HebiRobotics/hebi-matlab-examples/kits/lily/images/lily_axis.pptx

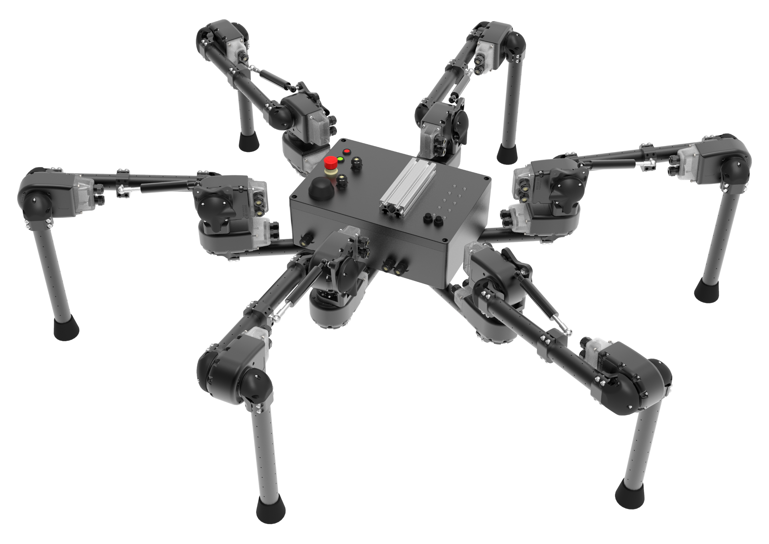
[picture p5: figure]

+z

+y

+x
