HebiRobotics/hebi-matlab-examples/kits/daisy/images/daisy_coordinates.png

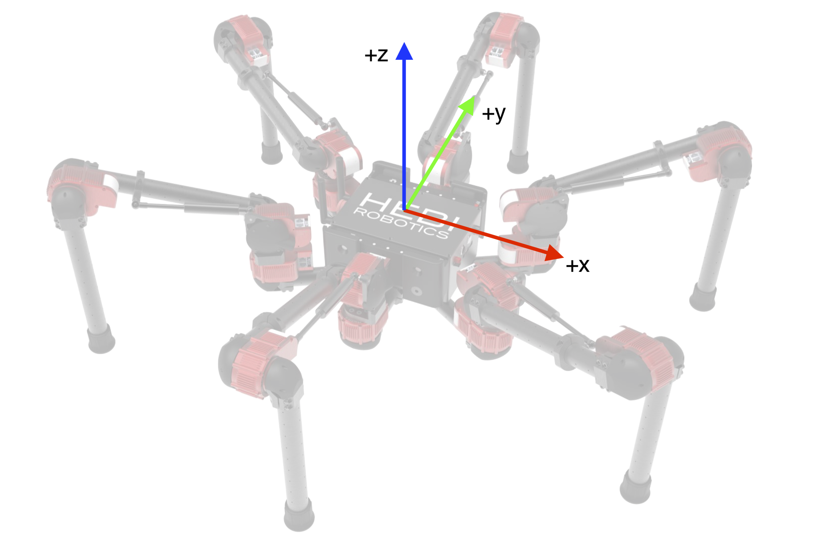
kits/daisy/images/daisy_coordinates.png
