HebiRobotics/hebi-matlab-examples/kits/lily/images/lily_render.png

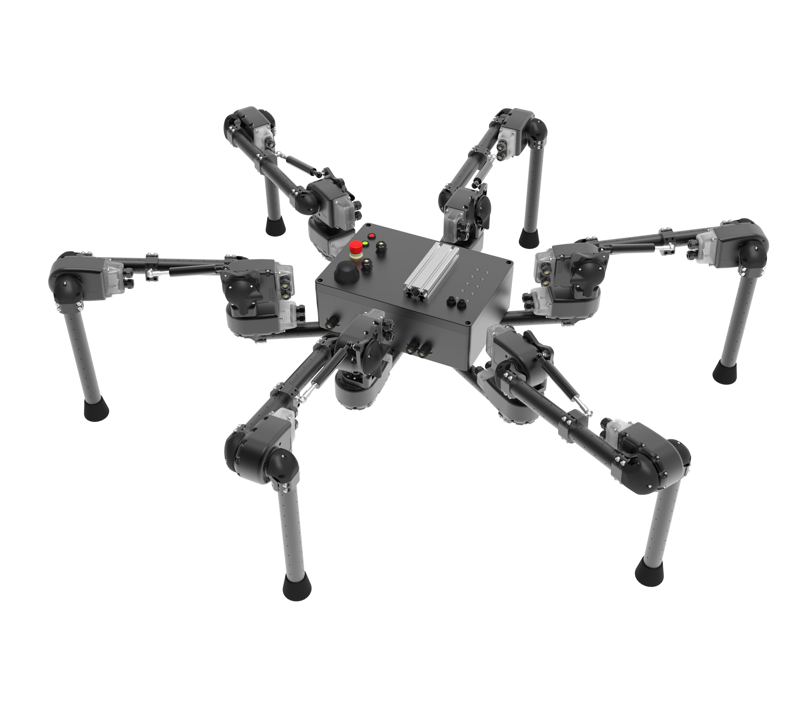
kits/lily/images/lily_render.png
