HebiRobotics/hebi-matlab-examples/kits/arms/hrdf/T25/hrdf/Can be converted to Mesh/Non-Simplified Size 55 Link/Size55Link.SLDASM

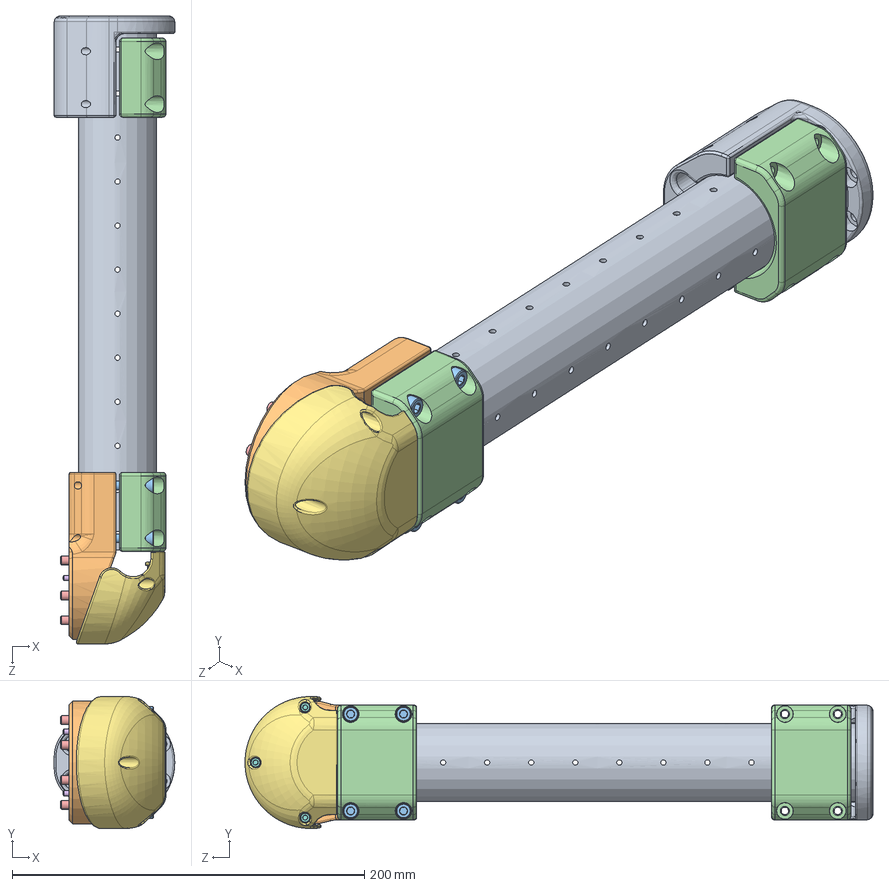
[picture p9: CAD file, 2024-07-16]
kits/arms/hrdf/T25/hrdf/Can be converted to Mesh/Non-Simplified Size 55 Link/Size55Link.SLDASM
68.5 x 75.0 x 356.5 mm
PM-3230-300
PM-3242-01
PP-2410-25 x 4
PM-3232-01 x 2
PP-2410-10 x 6
PP-2452-08 x 3
PM-3265-01
PP-2346-14 x 3
PM-3270-01
