HebiRobotics/hebi-matlab-examples/kits/arms/hrdf/T25/hrdf/Can be converted to Mesh/A-2638-01/A-2638-01.STEP

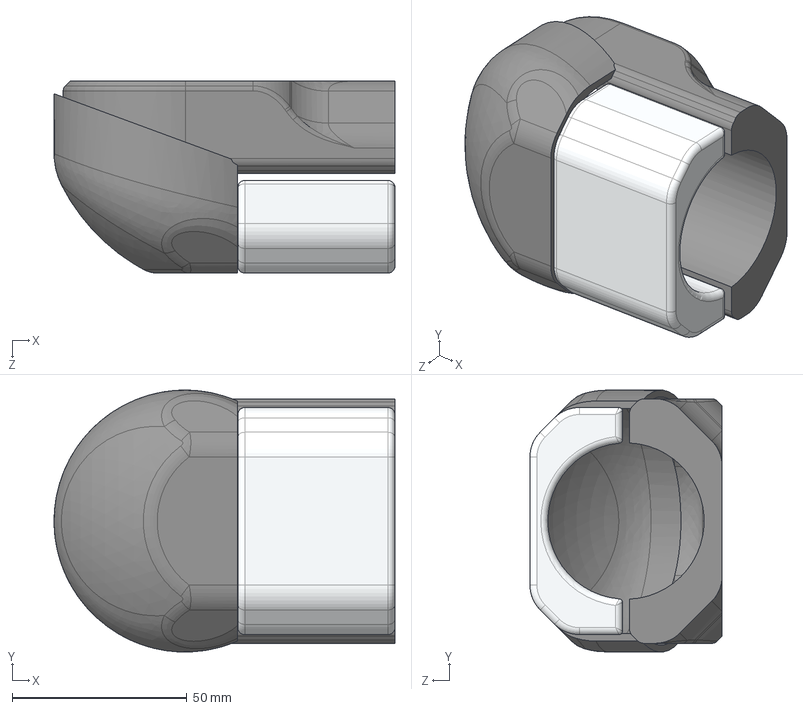
[picture p10: CAD file, 2024-07-15]
kits/arms/hrdf/T25/hrdf/Can be converted to Mesh/A-2638-01/A-2638-01.STEP
97.6 x 75.0 x 55.0 mm
PM-3231-01
PM-3232-01
PM-3252-01
