HebiRobotics/hebi-matlab-examples/kits/arms/hrdf/T25/hrdf/Can be converted to Mesh/A-2639-01/A-2639-01.STEP

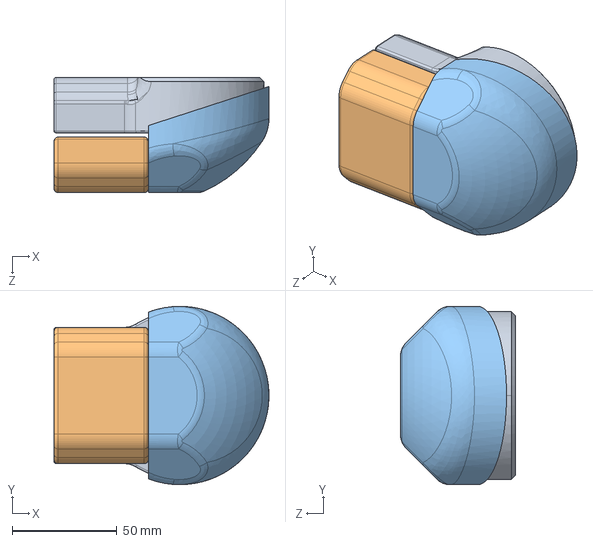
[picture p11: CAD file, 2024-07-15]
kits/arms/hrdf/T25/hrdf/Can be converted to Mesh/A-2639-01/A-2639-01.STEP
102.5 x 85.0 x 55.0 mm
