HebiRobotics/hebi-matlab-examples/kits/arms/hrdf/T25/hrdf/Can be converted to Mesh/A-2640-01/A-2640-01.STEP

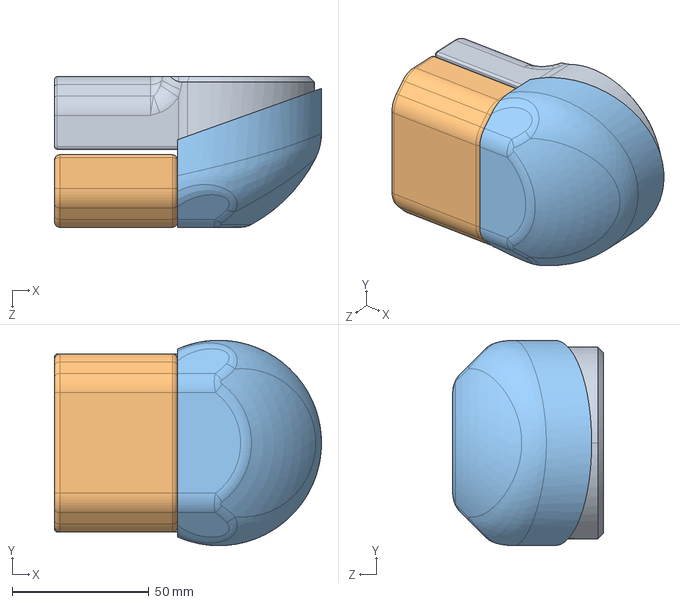
[picture p12: CAD file, 2024-07-15]
kits/arms/hrdf/T25/hrdf/Can be converted to Mesh/A-2640-01/A-2640-01.STEP
97.5 x 75.0 x 55.0 mm
