HebiRobotics/hebi-matlab-examples/kits/arms/hrdf/T25/hrdf/Can be converted to Mesh/A-2641-01/A-2641-01.STEP

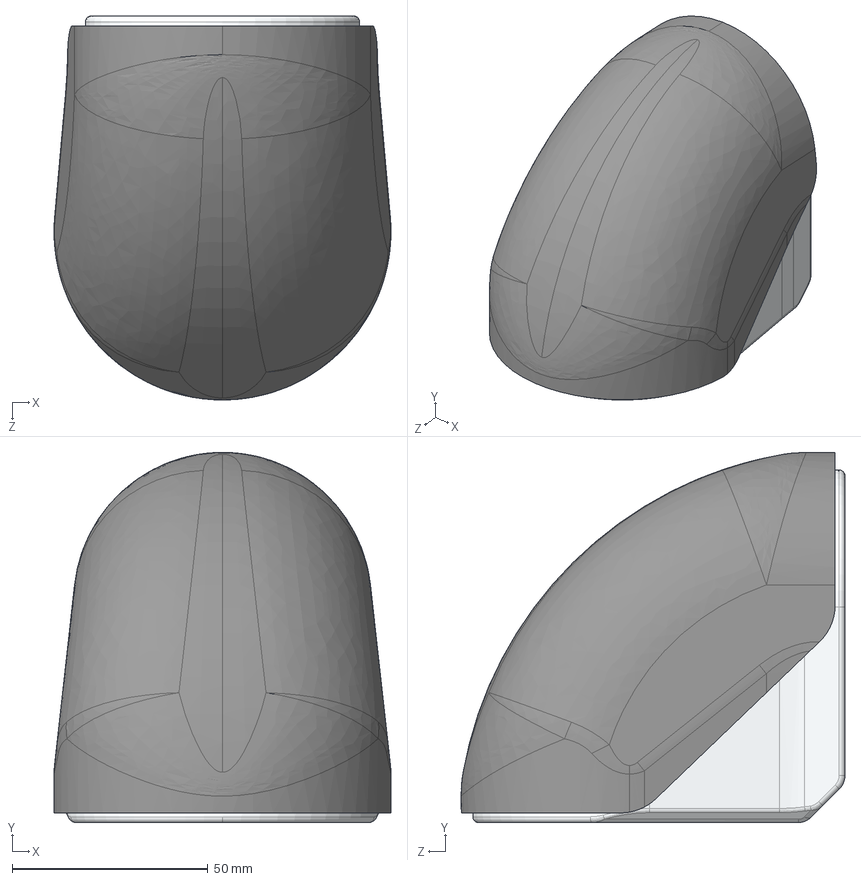
[picture p13: CAD file, 2024-07-15]
kits/arms/hrdf/T25/hrdf/Can be converted to Mesh/A-2641-01/A-2641-01.STEP
86.0 x 94.5 x 98.0 mm
PM-3245-01
PM-3266-01
