HebiRobotics/hebi-matlab-examples/kits/arms/hrdf/T25/hrdf/meshes/A-2641-01.obj

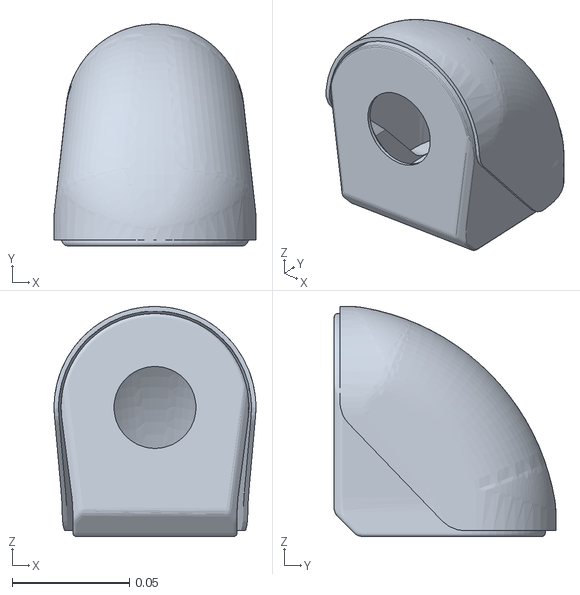
[picture p16: CAD file, 2024-07-15]
kits/arms/hrdf/T25/hrdf/meshes/A-2641-01.obj
0.086 x 0.0945 x 0.098
