HebiRobotics/hebi-matlab-examples/kits/arms/hrdf/T25/hrdf/Can be converted to Mesh/Non-Simplified Size 55 Link/Size_55_To_55_Inline_Link_Twist_0.SLDPRT

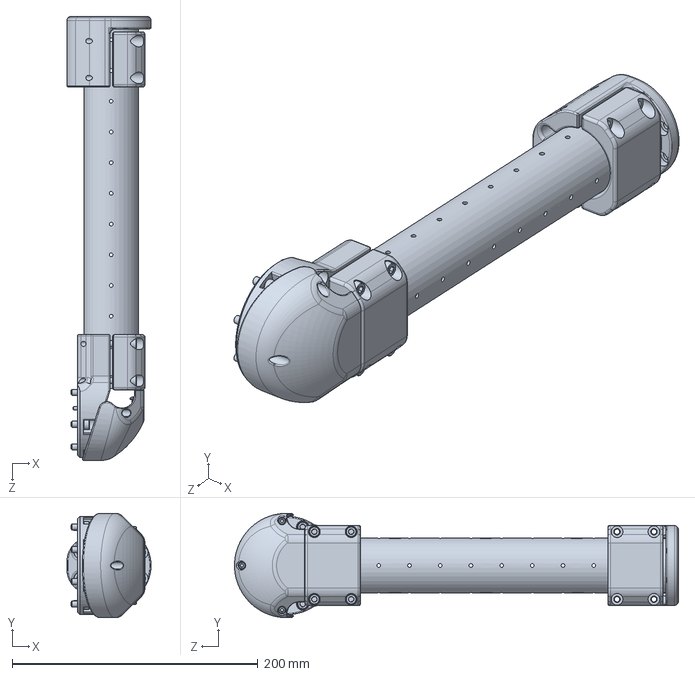
[picture p17: CAD file, 2024-07-16]
kits/arms/hrdf/T25/hrdf/Can be converted to Mesh/Non-Simplified Size 55 Link/Size_55_To_55_Inline_Link_Twist_0.SLDPRT
68.5 x 85.0 x 361.5 mm
