HebiRobotics/hebi-matlab-examples/(list of files, cad)

Other CAD files:
kits/arms/hrdf/T25/hrdf/Can be converted to Mesh/A-2642-01_Right_Inside/A-2642-01_Right_Inside.SLDPRT
kits/arms/hrdf/T25/hrdf/Can be converted to Mesh/A-2642-01_Right_Outside/A-2642-01_Right_Outside.SLDPRT
kits/arms/hrdf/T25/hrdf/Can be converted to Mesh/A-2642-01_Left_Inside/A-2642-01_Left_Inside.SLDPRT
kits/arms/hrdf/T25/hrdf/Can be converted to Mesh/A-2642-01_Left_Outside/A-2642-01_Left_Outside.SLDPRT
kits/arms/hrdf/T25/hrdf/Can be converted to Mesh/A-2642-01_Right_Inside/A-2642-01.STEP
kits/arms/hrdf/T25/hrdf/Can be converted to Mesh/A-2642-01_Right_Outside/A-2642-01.STEP
kits/arms/hrdf/T25/hrdf/Can be converted to Mesh/Non-Simplified Size 55 Link/Size_55_To_35_Inline_Link_Twist_0.SLDPRT
kits/arms/hrdf/T25/hrdf/Can be converted to Mesh/A-2638-01/A-2638-01.SLDPRT
kits/arms/hrdf/T25/hrdf/Can be converted to Mesh/A-2639-01/A-2639-01.SLDPRT
kits/arms/hrdf/T25/hrdf/Can be converted to Mesh/A-2640-01/A-2640-01.SLDPRT
kits/arms/hrdf/T25/hrdf/Can be converted to Mesh/A-2641-01/A-2641-01.SLDPRT
