HebiRobotics/hebi-matlab-examples/(threads)

Thread 22 (2018-06-19):

README for Igor

iamtesch, 2018-06-19:
It would be really helpful to have a "README" in the `kits/Igor` folder (and hexapod) explaining what the various startup scripts are there for, and which one to run/look at first when starting to use the kit.

iamtesch, 2018-06-19:
I see this is already done in the arm and Edward repos -- this would be great eventually, but even a 1-2 line README would help for Igor.

iamtesch, 2018-06-20:
Closing -- fixed with #23.

Closed 2018-06-20.

Thread 31 (2018-07-16):

Fix startup.m

daverolli, 2018-07-16:
Move to individual product, make sure `genpath` uses the path to the startup.m file rather than where the Matlab IDE is currently sitting.

ennerf, 2018-07-18:
Fixed in [1d722b5](https://github.com/HebiRobotics/hebi-matlab-examples/commit/1d722b5d6cb041456471a4abe5d9c49a34ba81e0)

Closed 2018-07-18.

Thread 59 (2018-07-24):

Overhaul arm kit examples

daverolli, 2018-07-24:
Suggested new examples (general to all kits):
* Forward Kinematics (show going thru preset joint waypoints)
* Forward Kinematics (controlling individual joints from sliders in Mobile I/O App)
* Inverse Kinematics (show going thru preset end-effector waypoints)
* Inverse Kinematics (controlling end-effector pose from sliders in Mobile I/O App)
* Gravity Compensation (with admittance control to hold steady)
* Impedance control (virtual wall or spring)

Suggested new examples (6-DoF w/ Gripper only):
* Teach Repeat (using Mobile I/O for input?)

Anything else?

Thread 63 (2018-07-30):

Add gas spring compensation to 6 dof basic example?

iamtesch, 2018-07-30:
In the robot 6 dof example in the "basic example" folder, it assumes no gas spring:

https://github.com/HebiRobotics/hebi-matlab-examples/blob/master/basic/x-series_actuator/ex7b_robot_6_dof_arm.m

This doesn't match our default 6DOF kit, and can lead to odd behavior in the case that this is run on a system with such a spring (b/c we are actively controlling efforts).

Should we make this a note somewhere in the file?  Or add gas spring compensation by default?

daverolli, 2018-07-30:
For the purposes of basic examples I prefer not getting into effort offsets, so adding a comment that the gas spring is off would be good.

I think the default we shoot for is that kits come with a gas spring, but I'm not sure its better have it installed by default.  I think its import to still build in support for it, but the need for a spring out of the box decreased a lot now that we have the X8-16.

Thread 102 (2019-11-18):

about motor torque controller

76328, 2019-11-18:
1.Is there any api for motor torque control?
2.Can I use the motor current and PWM to control motor torque for SEA output torque control algrothim design?
3.Dose the SEA support motor torque control like FOC?

daverolli, 2019-11-18:
> 1.Is there any api for motor torque control?
Yes.  The `effort` commands control the torque of the actuator.  This torque is measured and controlled directly on the output of the actuator using the sensed deflection of an internal spring.

> 2.Can I use the motor current and PWM to control motor torque for SEA output torque control algrothim design?
You can access the motor current in the actuator feedback, as well as command the PWM directly if desired.  So you can try closing the loop yourself for research.  However, actuators have high gear ratios, so it is unlikely that controlling current/torque of the motor directly would result in good control of output torque.

> 3.Dose the SEA support motor torque control like FOC?
The actuators do not currently support field-oriented control, or current-based control methods directly on the electric motor.  Torque control is provided by sensing directly on the output.

76328, 2019-11-18:
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

Wow,You means you use motor voltage (PWM) and a single PID loop to control the (output defelection)effort of SEA and achieve such high accuracy,it’s amazing! So Can I further ask an question,the PWM strategy is just like SVPWM technology?And there is no current based controller，you just control the output PWM which control the winding voltage，so the motor driver just like six step driver or sin wave driver not the FOC？

daverolli, 2019-11-18:
Correct, we have had good results by controlling the PWM to the motor (the winding voltage) and we do not use FOC.

Hope that helps.  If you'd like discuss more we'd be happy to continue the discussion via email at support@hebirobotics.com.

Closed 2019-11-18.

Thread 103 (2019-12-05):

How to use your winding current to calculate motor torque

76328, 2019-12-05:
I know the torque of your motor has some relationship of three phase winding currents
but the API only feedback one phase winding currents，so which phase dose it represent，and how to use it to calculate motor torque，and i want to use motor torque to do some control strategies

ennerf, 2019-12-05:
This touches internal firmware details, so we prefer to not discuss it in public issues. However, please feel free to reach out to us directly at support@hebirobotics.com

Closed 2019-12-05.

Thread 137 (2023-04-17):

How is feedback volume 'deflection' calculated?

Tom0514, 2023-04-17:
Hello, everyone!

      I am doing a single joint test, the joint model is `X5-9`. But I ran into a doubt, `deflection` is not equal to the value after subtracting the equivalent motor position from the joint position. In theory, shouldn't they be the same?

Best regards,
Xu.

ennerf, 2023-04-17:
Deflection is calculated from two encoders that are located before and after the spring attached to the output, i.e., they are after the gear train. The motor position is the position of the motor itself, i.e., it is before the gear train.

`motor -> [motor_position] -> gear train -> [deflection as offset from position] -> spring -> [position]`

ennerf, 2023-04-17:
The torque can be calculated using [Hooke's law](https://www.jamesspring.com/news/spring-constant/), i.e., `effort = -stiffness * deflection`. Note that the stiffness portion is negative, which may explain your sign error.

That being said, the springs in the X- and R-series actuators have some hysteresis effects and newer models use non-linear springs, so the stiffness depends on multiple factors and is not straight forward to compute. Each spring gets calibrated independently before shipping.

You may want to take a look at the `Encoders` section in Scope's log-viewer for more details. In the log file below the `J2_shoulder`  (red) joint shows a non-linear spring while `J5_wrist2` (green) uses a more linear spring.

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

Tom0514, 2023-04-17:
Hello, thank you for your reply!

> Edit: I somehow missed your code comment. It looks reasonable to me, but I'll ask someone else to double-check.

This code is just to verify `deflection = theta_link - theta_motor/N`, where `theta_motor/N` perform zero correction.

> The torque can be calculated using [Hooke's law](https://www.jamesspring.com/news/spring-constant/), i.e., `effort = -stiffness * deflection`. Note that the stiffness portion is negative, which may explain the sign error.

I can get the corresponding torque value through Hooke's theorem, but it has positive and negative numbers throughout the constant positive speed operation (sorry, the expression in the previous reply is too absolute, and it has positive and negative numbers in the figure). From the point of view of the formula, it should not be positive or negative.

> You may want to take a look at the `Encoders` section in Scope's log-viewer for more details. In the log file below the `J2_shoulder` (red) joint shows a non-linear spring while `J5_wrist2` (green) uses a more linear spring.

I drew it and it's a linear spring.
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

ennerf, 2023-04-17:
> This code is just to verify deflection = theta_link - theta_motor/N, where theta_motor/N perform zero correction.

That is not the case. The deflection comes from two dedicated absolute magnetic encoders and is independent of the motor and gear train. The motor-position is based on hall sensors and is not used in the effort computation at all. Between non-linearities in the encoders, gear backlash etc., I would expect the results to deviate a bit from each other.

> I can get the corresponding torque value through Hooke's theorem, but it has positive and negative numbers throughout the constant positive speed operation (sorry, the expression in the previous reply is too absolute, and it has positive and negative numbers in the figure). From the point of view of the formula, it should not be positive or negative.

Could you send us a log file to support@hebirobotics.com? A subject line "hebi-matlab-examples#137" without any text would be enough.

Tom0514, 2023-04-17:
> That is not the case. The deflection comes from two dedicated absolute magnetic encoders and is independent of the motor and gear train. The motor-position is based on hall sensors and is not used in the effort computation at all. Between non-linearities in the encoders, gear backlash etc., some deviation between the two values is to be expected.

Thank you for answering my doubts. The calculation given by the dynamic model of the joint is too ideal.

> Could you send us a log file to [support@hebirobotics.com](mailto:support@hebirobotics.com)? A subject line "hebi-matlab-examples#137" without any text would be enough.

OK, I'll send it right now.  Thank you for your answer, much appreciated!

ennerf, 2023-04-18:
The torque readings aren't great, but not out of whack for a 5 year old actuator. However, the commands are a bit weird.

You are using `DIRECT_PWM`, but something is making the command oscillate. Are you using some custom controller on top or maybe have safety limits set?

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

Tom0514, 2023-04-19:
Thank you so much! ennerf.

> You are using `DIRECT_PWM`, but something is making the command oscillate. Are you using some custom controller on top or maybe have safety limits set?

There are no other controllers on the top layer, I just control the PID to achieve constant speed movement. The safety limit parameters are set as follows:

``` matlab
safetyParams = group.getSafetyParams();
safetyParams.positionLimitStrategy = 3;        % damped spring
safetyParams.positionMinLimit = -3*pi;
safetyParams.positionMaxLimit = +3*pi;
```

Tom0514, 2023-04-19:
> What PID controller are you referring to? You are using DIRECT_PWM, which bypasses all built-in PID controllers.

Basically follow this example to write: [`ex1_custom_pid_1_controller.m`](https://github.com/HebiRobotics/hebi-matlab-examples/blob/master/advanced/ex1_custom_pid_1_controller.m)  The parameters used are `P` and `D`.

> Please try switching to Strategy 3 or 4 (see [documentation](http://docs.hebi.us/core_concepts.html#control-strategies)) and commanding velocity.

I saw in [`Choosing a Control Strategy`](https://docs.hebi.us/core_concepts.html#gain-tuning) that the `Direct PWM` strategy is suitable for system identification, so I used it. I also tried `strategy 4` and set the parameter of effort PID to 0, but the effect was worse than `strategy 1`.
I didn't tune the parameters of the position and velocity PID in `strategy 4`, because I found that even when the position and effort were set to zero, the velocity and effort still fluctuated, and I don't know if it can achieve a constant and precise speed tracking. So I use `strategy 1` to track the position of the linear transformation, so as to realize the speed tracking indirectly.

Tom0514, 2023-04-19:
> Did you zero the commands or the gains? The position/torque controller should be disabled, e.g.,

Sorry, I didn't express myself clearly.  When the joint is not running, the speed and torque still fluctuate after setting the zero position in `Scope`. When I use `strategy 4`, I only send velocity commands:

```matlab
cmd = CommandStruct();
cmd = CommandStruct();
```

Closed 2023-04-21.

Thread 139 (2023-05-10):

Can a current controller be implemented with a direct PWM strategy?

Tom0514, 2023-05-10:
Hello, ennerf !

I'm testing the `MPC` algorithm in a joint, and my control input signal is the motor winding current, i.e. `windingCurrent`. When testing the joint, I scaled the value to the `[-1,1]` interval and sent it to the motor with a `direct PWM` strategy, but the actual effect was far from the simulation result.

So, I want to track the current signal by cascading a bottom PID current controller. But when writing the current controller on the `direct PWM` strategy and applying it to the joint, the LED of the joint turns red and then makes a screeching sound. Is it possible to implement a current controller under `direct PWM` strategy? Thanks!

Best regards,
Xu.

ennerf, 2023-05-10:
It is generally possible to run a current loop on PWM (this is how FOC works in a nutshell), but it is generally timing critical and should be done in firmware. The actual equation that scales voltage to current in a motor should include the motor velocity and the winding resistance.

You are going to run into timing issues when doing it over the network, but you can maximize the feedback rate and hope for the best. As a first debugging step I'd recommend looking at logs and checking what your PWM commands look like. The red LED and sound probably indicate that your controller is unstable and oscillating.

Tom0514, 2023-05-11:
Thank you for your reply!

> You are going to run into timing issues when doing it over the network, but you can maximize the feedback rate and hope for the best.

Doesn't changing the feedback frequency affect the sampling time of `MPC`?  My sampling time is `0.01s`, so I set the feedback frequency to `100Hz`.

> The red LED and sound probably indicate that your controller is unstable and oscillating.

In the early stage of `MPC`, the output current signal has a large oscillation. I think this may be the reason. I will try to add constraints to the control input rate.

For the joint `X5-9`, when setting the state variable of `MPC` and the upper and lower bounds of the control input, the parameters I set are:

```matlab
% The state variables correspond to motor position, motor speed, link position and link speed
lbx = -1*[pi, 14/9.55, pi, 14/9.55];
ubx = +1*[pi, 14/9.55, pi, 14/9.55];
% control input: Motor winding current
lbu = -1.6;
ubu = +1.6;
```

The current is set according to the peak current in the parameter table (`1.6A @ 36V`), the speed of the motor and link is obtained from the maximum speed (`14 RPM`), and the constraints of the position of the motor and connecting rod are self-selected (`+/- 4 rotations (8 x 360-degree total range)`). Is this reasonable? Thanks!

Tom0514, 2023-05-12:
> For the joint X5-9, when setting the upper and lower bounds of the state variable and the control input of MPC, the parameters I set are:

This can give `+1/-1` commands under the `direct PWM` strategy to observe the joint output, so as to obtain the relevant upper and lower limit values.

Tom0514, 2023-05-18:
Hello, ennerf!

I have designed a `PI` current controller with a feedback frequency of `1000Hz`, and when I am tracking a fixed value of 0.1A/0.2A, it is tracking ok. But today when I was trying to trace a sequence of control input signals from the `MPC` solution, it had a problem.

Then when I try to track a higher fixed value of current under this `PI` parameter again, the feedback results are almost the same, and there is no tendency to track the target at all.

Here is my feedback plot for tracking a fixed value of current using a `PI` controller (`P-0.2`, `I-50`):
- [0.1A](https://github.com/Tom0514/issue/blob/main/0.1A.png)
- [0.2A](https://github.com/Tom0514/issue/blob/main/0.2A.png)
- [0.3A](https://github.com/Tom0514/issue/blob/main/0.3A.png)
- [0.4A](https://github.com/Tom0514/issue/blob/main/0.4A.png)
- [0.5A](https://github.com/Tom0514/issue/blob/main/0.5A.png)

The control input signals of the MPC and the corresponding simulation results (state trajectory and reference trajectory) are as follows:
- [the mpc control inputs](https://github.com/Tom0514/issue/blob/main/the%20control%20input.png)
- [state&reference trajectory](https://github.com/Tom0514/issue/blob/main/state%26reference%20trajectory.png)

Track the control input signal under the `PI` parameter:
- [track control input](https://github.com/Tom0514/issue/blob/main/mpc.png)

Is this a problem with the `PI` parameter? Why this happens, I have a hard time understanding. Here is my [code](https://github.com/Tom0514/issue/blob/main/hebi_current.m).

Hope you take a look! Thank you so much!

Best regards,
Xu.

ennerf, 2023-05-19:
I tried running your code, and I think you are running into at least two issues:

1. You may be commanding something that is physically impossible. On an unloaded X8-3 going full tilt I get a maximum motorCurrent of 0.15 amps. I'd recommend doing a sanity check where you command max pwm and check what the output is for your system.

2. You are not capping the i term, so the controller is running into [integral windup](https://en.wikipedia.org/wiki/Integral_windup) and can't recover.

Tom0514, 2023-05-19:
Thank you for your reply!  I'm going to double-check the two points you raised.  Thanks again!!!

Tom0514, 2023-05-19:
> You may be commanding something that is physically impossible. On an unloaded X8-3 going full tilt I get a maximum motorCurrent of 0.15 amps.

Sorry, the output of my actual `MPC` is `windingCurrent`, I looked at the uploaded code and wrote `motorCurrent`. At that time, in order to verify whether it was a problem with tracking signals, I tested `motorCurrent`, but I looked at the log files, and it seemed that the tracking could not be achieved.

I'll check the problem again, I'm really sorry.

Closed 2024-01-12.

Thread 141 (2024-01-12):

What is the relationship between motor current or winding current and PWM?

Tom0514, 2024-01-12:
Hello, author！

Is there a corresponding relationship between the motor current or winding current of the HEBI X5 series joints and PWM? Can I fit the mapping relationship between them through a neural network to achieve a current controller?

Looking forward to your reply, thank you very much!
