HebiRobotics/hebi-matlab-examples/(commit log)

2017-07-26 overhauled basic kinematics example
2017-08-22 * updated examples to use 1.0rc2 (torque => effort) * added non-blocking trajectory example
2017-08-28 added start for arm-kit code. Started with 5 dof I had on hand.
2017-08-29 changed output to point forward, added switch for disabling effort control
2017-08-29 sample video and control stratgies
2017-09-21 added example for shared memory communication and custom pwm controller
2017-10-09 Added hexapod code
    Added latest hexapod code from SVN. This has been updated to use the
    latest API, but hasn’t yet been tested on a real robot.
2017-10-11 Demo updates
    Simplified some of the gravcomp spring example and target chase
    example. setupArm now does a 5DOF arm that matches the configuration
    for the Nihon feeding arm. Added ignores for .hebilog.
2017-10-12 First draft of feeding demo
    Code for teach-repeat feeding, based on ex_teach_repeat.m. Added some helper tools for rotations, kinematics, visualization, etc.
2017-10-12 Changed kinematics to 'left'.
    Changed to match Nihon Binary's hardware parts.
2017-10-16 Added ability to nudge waypoints after training.
    Added IK-based waypoint adjustment after training using the arrow keys. Added a set of the base frame of the arm so that the keyboard input can be oriented correctly.
2017-10-23 added joystick sample to readme
2017-11-14 Added default gains for example 3DOF arm.
2017-11-14 Changed hackathon folder name
    Change hackathon folder name, and updated with another example of an arm that used a bottle opener to open drinks.
2018-02-12 Beverage Arm Demo
    Updated hebi API to latest version. Added code for 5DoF Arm w/ Gripper
    (Beverage Demo for PRN Event).
2018-03-02 Revert "Beverage Arm Demo"
    This reverts commit 9ec50266704f6e489db257b45fe279011663f28b.
2018-03-09 fixed arm kit startup and removed utility functions that have moved to HebiUtils API
2018-03-09 * added all standard arm kits to setupArm (breaks current demos) * updated readme
2018-03-09 changed feeding arm and youtube demos to use shared include folder
2018-03-09 added 6 dof IK for 6dof arm joystick chase
2018-04-23 fix gains for no camera Igor config
2018-05-14 Added IO board youtube demo code
2018-06-29 Added mobile device demo
    Added control from mobile phone, basically the Rosie demo, but without the mobile base. Added gain-setting for the 6-DoF arm, loading from an XML file.
2018-07-17 Reorganized utilites
    Removed unused utilities. Moved shared memory helpers to utils/. Moved frameDisplay to kinematics/. Got rid of unknown/.
2018-07-18 Basic examples update (#30)
    * Updated API version
    Updated to latest API, pre-release version of 1.4
    * Removed old files. Kept startup.m
    * Removed old resources folder
    * Added README
    * Added Lookup examples.
    * Added feedback examples
    Added 2 examples for getting feedback in a loop, with and without logging. Also fixed the descriptions on some of the lookup examples.
    * Added command examples
    Added command examples. Removed note about maybe doing single modules from the readme. Added some printouts to the feedback examples to encourage people to mess with the module while gathering feedback.
    * Added closed-loop command example.
    Added exmple using gyro to sen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
2018-07-20 Updated frameDisplay() to allow fixed xyz limits
2018-07-23 Dave Rosie kit updates (#49)
    * Added Rosie code.
    * Fixed coordinate convention and startup crash for omnidrive
    * Added arm gains
    * Updated with setting gains for the arm.
    * Updated demo runner for omni-base
    * Added gripper force scaling based on setup parameters.
    * Resolved conflicts with master
    * Commented out 'clear' commands in SpinCalc
    * Fixed minor comments typos
    * Removed local `hebi` API - Changed `include.m` to use the main examples API. Removed all the local versions of the API and tools.
    * Added gains and HRDF files
    * Updated orientation code to use fixed axis limits.
    * Added placeholder for unified Rosie Demo
    * Updated to API 1.4.2
    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
2018-07-30 Basic mobile examples (#60)
    * Changed 'hexapod' to 'daisy'
    * Updated startup script
    * Re-orged gains in arm kit.
    * Added logging to Mobile I/O example
    * 3 tabs to 2 tabs
    * Initial commit of scanning arm.
    * removed logging from earlier examples, added example with IO and mobile fbk
    * Changed to remove `vecnorm`
    Do vector norm manually so that demo works with older versions of Matlab
    * Added axis labels.
2018-07-30 change plane of box in IK example (#65)
    Again, for 6DOF arm, the area around the ray [0.2, 0.2, z > 0] seems to be a bad area of the workspace.
2018-07-30 Change path in IK example (#62)
    On the basic IK example, it traces a straight line from [0.5, -0.2, 0] to [-0.5, -0.2, 0]. This works OK on the 3 dof arm, but points that are passed through in the vicinity of [0.2, -0.2, 0] tend to be a little collision prone with a 6 DOF arm, given the wrist and the gas spring. I found a trajectory of [0.5, -0.2, 0] to [0.5, 0.2, 0] to work better here, and I think it would work well on the 3 DOF arm as well. It also seems to center better in the default workspace (so an elbow up configuration with base angle "0" is in the middle).
    Thoughts?
2018-07-31 Add an advanced IK example demonstrating IK error (#69)
    * Add an advanced IK example demonstrating IK error
    - demonstrates how to compute cartesian error from target position to
    IK solution
    - demonstrates behavior when target point is outside of the workspace
    or the arm begins at a singularity.
    * Added HRDF and fixed reference in code.
2018-08-14 Fixed arm gains file capitalization issues.
2018-11-02 Arm kit updates (#73)
    A whole mess of changes to the arm kit. Main updates are now using gains XML files for all arms and using HRDF for all the kinematics. Also did a rework of the examples based on new tools like the Mobile I/O app and trying to make things easier to extend for specific applications, like the `ex_teach_repeat` examples.
    * Added scanning demo
    * Added some bells and whistles
    Use the mobile app to start / jog / pause.
    * Update to use Mobile Device API
    Took out the co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
2018-11-30 Fixed bug with Shoulder bracket configuration (#76)
    Chaged 'RightOutside' to 'RightInside'.
2019-04-05 Willig updates to Igor 2 MATLAB example (#80)
    * Mobile IO Igor from Joystick
    Updating Igor MATLAB example code to work from Mobile IO instead of joystick.
    * Igor Mobile IO bugs
    Made bug fixes to igor demo with mobile IO
    * Update igorStart.sh
    fixed .sh file called directory.
    * Update igor2DemoIntegrated.m
    changed some LED sequencing. and removed a break that caused demo to startup while paused and disconnected controller.
    * Update igor2DemoIntegrated.m
    Included try/catch for if app closes while demo is running.
    * Update igor2DemoIntegrated.m
    removed excessive try catch in control loop. My bad!
    * Update igor2DemoIntegrated.m
    updated igor Mobile IO code wi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
2019-04-17 Update igor2DemoIntegrated.m (#85)
    Re-tuned balance control for upcoming improvements to the pose filter. Added mobile control state-setting. Added velocity control integral gains to slider A5.
    * Added note about firmware version to the README
    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
2019-06-12 Create 5-Dof arm with gripper (#98)
    * Create 5-Dof arm with gripper
    * Added 5-DoF Arm w/ Gripper. Changed gas spring default to false.
2019-12-02 R-Series Hexapod in MATLAB
    Starting to get things working for R-Series Hexapod. Scaled gains up to 1.0 from 0.5. Adjusted some chassis masses. Waiting on gas springs to do more development.
2019-12-03 More work
    Fixed some kinematics issues in terms hrdf formatting and bugs that Florian fixed in 1.6.3-SNAPSHOT. Made larger stance radius and step period. Trippled Position and Velocity P gains. still some leaning issues, but she can walk a little!
2019-12-11 Added Springs to R-Series Hexapod - Lily
    Calling R-Series Hexapod - Lily (Water Lily). Added effort compensation for springs back as I installed the 30lbs gas springs.
2019-12-17 Update readme.adoc
    updated readme doc for arm examples to include r-Series.
2019-12-19 Cleaned up Daisy
    Removed Lily draft code. Made changes for Daisy to use new MATLAB API (updating HRDFs and some frames stuff). Tested both Daisy and Lily on physical robots. This MATLAB code is pretty basic to get people started.
2020-01-20 MATLAB Arm Examples Update (#106)
    * MATLAB Examples update Arm Kits
    Using Kit Part Numbers for HRDF and gain files. Updated all examples to no longer use `series` and the `names` are all by Kit Part Numbers. Updated the ReadMe file to match changes.
    * Added comments
    Added comments for gripper spool gains files and callouts on setupArm.m
2020-01-20 Add R-Series SCARA to MATLAB Arm Examples (#107)
    * Added R-Series SCARA Arm
    Added R-Series SCARA Arm HRDF, gains and to setupARM. Fixed X-Series SCARA HRDF kinematics.
    * Update A-2302-01.xml
    fixed comment
2020-03-20 Arm interface (#109)
    **HebiArm**
    * Added experimental `HebiArm` API
    * Updated Arm examples
    * Added `HebiArmPlugins` for functionality extensions
    **lib**
    * Updated API to 1.7.1
    * Added `diffKeys` to `HebiKeyboard`
2020-06-08 Igor Naming Convention Update
    Updating the naming of actuators and controller in terms of family and names per the HEBI standard naming convention doc.
2020-06-22 Adding Mecanum Base Functionality to Rosie MATLAB Demo (#113)
    * basics of a mecanum base code working
    This is just some basics to get the mecanum base working in MATLAB for Chris to base stuff on for the ROS example. Will eventually make a version that gets implemented into the rosie demo.
    * Added Mecanum support to Rosie demo
    Based this off of the ROS and teleop taxi work we did for Ericsson. We have already shipped the Ericsson base so I did not get a chance to test this, but I did some simulated tests making sure that the outputs from the wheelVelocityMatrix are correct.
    * update to naming conventions for mobile base wheels
2020-06-22 Added a plugin to work with double-joints (#114)
2020-06-22 fixed empty gripper behavior
2020-07-02 naming convention quick fix for gripper in setupArm
    changed from "Spool" to "gripperSpool" as per naming convention
2020-09-16 changed impedance controller to PID (#120)
    * added full PID to impedance controller
2020-10-02 Updates to FrameDisplay (#123)
    * Fixed window resizing bug on auto-sized axes.
    * Added lines connecting the different frames.
    Also removed legend, and made fields public. Not sure if that is a good idea.
2020-11-09 accounted for base frame in gravcomp and added FK / Jacobian to common state (#125)
2021-01-14 puttng Igor chassisCoM variable back to the original way it was written. (#127)
2021-04-16 removed unused pose filter (#129)
2021-09-28 fixed wheel translations (#132)
2021-10-07 added utility to remove boiler plate code and updated all mobileIO examples
2023-11-27 initial implementation for arm plugin configs
2023-11-28 fixed impedance controller plugin
    [A-2085-06.yaml]
2024-01-12 implemented double joint mirror plugin
2024-07-15 Created hrdf for arm components and added most meshes
    [A-2610-25.SLDPRT, A-2631-01_Output_Tube_Adapter_Size_55.obj, A-2632-01_Input_Tube_Adapter_Size_55.obj, A-2634-01_Input_Tube_Adapter_Size_55_to_Size_35.obj, A-2635-01_Inner.SLDPRT, A-2635-01_Outer.SLDPRT, Size_55_Link_Twist_Pi.SLDASM]
2024-07-15 Finished adding meshes, made size 55 linkage assembly
    [A-2610-25.SLDPRT, A-2631-01_Output_Tube_Adapter_Size_55.obj, A-2632-01_Input_Tube_Adapter_Size_55.obj, A-2634-01_Input_Tube_Adapter_Size_55_to_Size_35.obj, A-2635-01_Inner.SLDPRT, A-2635-01_Outer.SLDPRT, A-2642-01.STEP, A-2642-01_Left_Inside.SLDPRT]
2024-07-15 Added simplified mesh models
    [A-2638-01.SLDPRT, A-2638-01.STEP, A-2639-01.SLDPRT, A-2639-01.STEP, A-2640-01.SLDPRT, A-2640-01.STEP, A-2641-01.SLDPRT, A-2641-01.STEP]
2024-07-16 Added light 90 degree bracket and other small changes
    [A-2641-01.obj, Size55Link.SLDASM, Size_55_To_35_Inline_Link_Twist_0.SLDPRT, Size_55_To_55_Inline_Link_Twist_0.SLDPRT]
2024-07-25 T25 quick demo... need to cleanup... some HRDFs are backwards
    [A-2638-01.SLDPRT, A-2638-01.STEP, A-2639-01.SLDPRT, A-2639-01.STEP, A-2640-01.SLDPRT, A-2640-01.STEP, A-2641-01.SLDPRT, A-2641-01.STEP]
2024-07-29 Fixed Inside heavy brackets left vs. right
